syj766/stm32-digital-clock/README.md

# STM32 数字钟（硬件工程）

基于 STM32F103C8T6 核心板的 4 位数码管数字钟。原理图、PCB、DRC、自动布线、铺铜均已完成，并通过嘉立创打样 + BOM 配单下单。

本仓库保存同一原理图的**两版 PCB 设计**：原理图自 V1 起冻结不变，PCB 每版从头重新设计。

> ⚠️ **复刻 / 烧录请用最新 `main` 分支。** 历史版本（含早期 tag）仅供了解演进过程，**不要直接烧录**——引脚分配、蜂鸣器驱动、上电与 RTC 行为都在后续提交中修正过。

> 📌 **最终代码在 [`firmware/最终功能代码/`](firmware/最终功能代码/)**
> 用它覆盖 `firmware/Core/` 中的同名文件即为功能完整的最终工程。
> `firmware/Core/` 保留的是**硬件自检阶段**的旧版本，仅供对照，不要直接烧录。

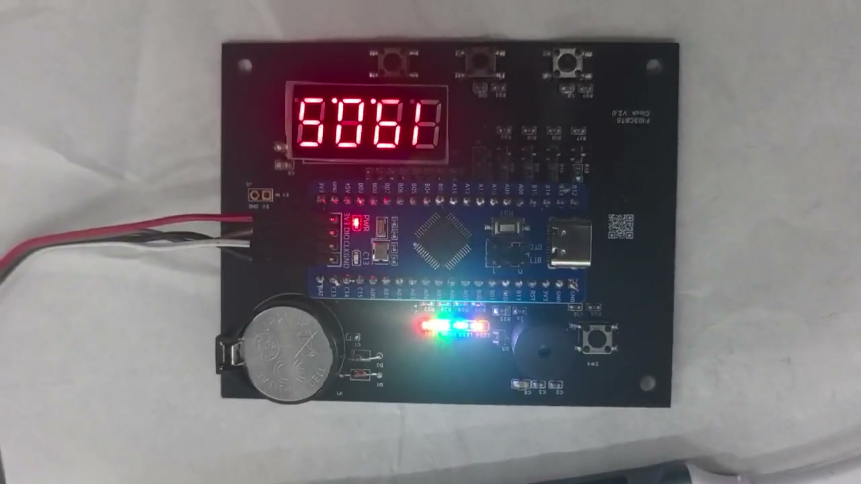
[picture p1: docs/demo/cover.jpg]
数字时钟功能演示（点击封面跳转 B 站播放） (https://www.bilibili.com/video/BV1qnpd61E5a/)


> 📺 **在线观看（B 站）**：[数字时钟功能演示](https://www.bilibili.com/video/BV1qnpd61E5a/)（1 分 50 秒）
>
> 🎬 **仓库内离线版**：[数字时钟功能演示.mp4](docs/demo/数字时钟功能演示.mp4)（720p · 12 MB 压缩版）

| 版本 | tag | 冻结日期 | 说明 |
|---|---|---|---|
| V1 | `v1.0-frozen` | 2026-10-03 | 首版 PCB，产物在仓库根目录 |
| V2 | `v2.0-frozen` | 2026-10-04 | PCB 全面重设计，产物在 `*/v2/` 子目录，详见第十一章 |

- **设计工具**：嘉立创EDA 专业版 V4.1.60

---

## 零、开发总流程（最终版）

> 原则：**IOC 图形化配置 + AI 交叉检查通过后，才开始写代码。**

```text
嘉立创EDA：原理图（引脚分配定稿）→ PCB → ERC / DRC → 打 tag 冻结硬件版本
   ↓
导出四件套放进同一个文件夹：功能需求.md、.epro2、原理图 PDF / 截图（BOM、网表可选）
   ↓
CubeMX：时钟树 + 激活外设 + 处理 Debug/JTAG → 生成 HAL 工程（即“新建空文件夹”）
   ↓
AI 交叉验证：网表 ↔ .ioc ↔ 截图 三方互查，产出 ①比对报告 ②pinmap.h
   ↓
按 .ioc 修正意见重新生成（如需要）→ 定代码框架、写驱动骨架
   ↓
填应用逻辑，上板先跑引脚级自检（按键回显、全段点亮、蜂鸣一声），再上真逻辑
```

**当前进度**：`pinmap.h` 已产出；**焊接后硬件自检程序已完成**（见 [`firmware/`](firmware/README.md)）；⏳ 数字钟功能逻辑待实现。

> **实战：一次 AI 交叉验证如何挖出 .ioc 的 bug（以本工程为例）**
>
> 三方比对时，判断先后从"最省事"到"最实锤"，顺序决定你能否发现隐藏错误：
>
> 1. **先读 `clock.ioc`** → 只知道方向（12 个输出、4 个输入），**看不出谁是谁**；
> 2. **再看原理图截图** `03_5v_input.png` → 拿到"标签 → 引脚"映射，注意 **`SEG_G` 排针 11 脚 = PB3**；
> 3. **解包 `.epro2` 解析 PCB 焊盘网表** → 40 个焊盘逐一实锤，**和截图一致**；
> 4. **拿这份实锤网表回头比对 `.ioc`** → 才发现 **`.ioc` 配了 PA3、漏了 PB3**；
> 5. **把核实结果 + 极性一起写进 `pinmap.h`**。
>
> ```text
> (.ioc: 只有方向) → (截图: 标签→引脚) → (.epro2网表: 40焊盘实锤)
>                                                            ↓
>                           回头比对 .ioc → 抓到 "PA3 重复 + PB3 漏配"
>                                                            ↓
>                                   核实 + 极性 → 写入 pinmap.h
> ```
>
> 结论：**先有鹰眼（截图方向）→ 再用探针（焊盘网表实锤）→ 最后照妖镜（回头比对 .ioc）**，三者缺一不可。

---

## 零·五、STM32 调试口（SWD / JTAG 释放）

> F103 的 **PA13/PA14 是 SWD 调试口**（ST-Link 烧录调试走它），**PA15/PB3/PB4 是 JTAG 脚**，
> 复位后 **5 个全部被调试口占用**。本数字钟拿 **PB3/PA15/PB4 当段选脚**，
> 所以必须在 CubeMX 的 `SYS → Debug` 里释放 JTAG。

**三挡怎么选（结论先行）：开发板一律 `Serial Wire`**

| Debug 挡位 | 释放 JTAG 3 脚 | 保住 SWD(PA13/14) | 适用 |
|---|---|---|---|
| `Serial Wire` | ✅ | ✅ | **开发期唯一正确选项** |
| `Full` | ❌ 全占用 | ❌ | 需 JTAG 时 |
| `No Debug` | ✅ | ❌ 一起禁掉 | 仅量产 / 引脚不够用的极端 |

- **`Serial Wire`**：释放 JTAG 的 PA15/PB3/PB4（拿去当段选），同时保住 SWD（继续可烧录调试）。
- **`No Debug`**：虽然也释放了那 3 个脚，但把 SWD 也一起禁了——**固件一跑调试口就断**，
  下一次烧录热插拔连不上（只能靠拉 NRST 复位下连接，或 BOOT0 救回）。只留给量产且引脚不够的极端情况。
- **烧录发生在固件运行之前**，所以 `No Debug` 不影响**第一次**烧录，**坑的是之后每一次**。

**验收标准**：`hal_msp.c` 里出现 **`__HAL_AFIO_REMAP_SWJ_NOJTAG()`**（即 Serial Wire 已生效，JTAG 释放、SWD 保留）。

---

## 一、架构与集成（定稿）

### 1. 架构

```
        ┌─ main.c（永远只有 5 行，全部落在 USER CODE 段）
        ├────────────────────────┐
        ▼                        ▼
   app.c/.h                 hw_test.c/.h
   应用层：课设逻辑唯一所在    上电自检（唯一允许跨层直推的模块：
        │                    蜂鸣器走 buzzer 驱动、输出走 uart_console）
        │ 装配并调度以下 6 个业务模块
   ┌────┬────┬────┬────┬────┴─┐
seg_display key led buzzer uart_console clock_time
   │    │   │    │      │          │
   └────┴───┴──┬─┴──────┴──────────┘
               ▼
        pinmap.h（引脚+极性唯一事实来源，纯宏无 .c）
               ▼
   CubeMX 生成物（不碰）：main.c 内 MX_GPIO/USART1/TIM3_Init
                        + stm32f1xx_hal_msp.c + Drivers/
   （本工程 CoupleFile=false，无独立 gpio.c/usart.c/tim.c）
```

**三条铁律**：① 引脚宏只从 pinmap.h 取；② 业务模块之间不横向 include，经 app.c 汇聚——**hw_test 是唯一例外**（自检必须跨层直推才能定位故障）；③ main.c 只认识 app.h 与 hw_test.h。

**main.c 的 5 行**（顺序硬约束：`app_init()` 在 `hw_test_run()` 之前，理由见易错点①）。

### 2. 操作清单（已完成 ✓，留档备查重做）

| # | 操作 | 验证 |
|---|---|---|
| ① | 9 个 .h → `Core/Inc`、8 个 .c → `Core/Src`（源：clock_code，**该暂存区已删除**；恢复源=ZCode 工作区备份；**以 Core/ 现行版为准**） | 目录数 12 / 14 |
| ② | 根 CMakeLists.txt `target_sources` 加 8 个 .c | 逐行对上实存文件 |
| ③ | it.c：Includes 加 `clock_time.h` + SysTick 0 段加 `clock_time_isr_1ms();` | grep 两名各 1 次 |
| ④ | main.c 5 行落 USER CODE 段，`app_init` 先行 | 上下文目视 |
| ⑤ | `cmake --preset Debug` + `cmake --build build/Debug` | `Built target clock` |
| ⑥ | 烧录 clock.elf | 上电验收单 |

### 3. 上电验收单

```
LED 流水×2 → 8.8.8.8. 全亮 → 逐位 ×2 → 逐段 → 哔哔哔——哔 → Do Mi So Do↑
→ K1~K4（LED+键号+响）→ 双响 → 00:00 走时（首次上电；有 VBAT 备电则续上次时间）、冒号闪、LED1 心跳、串口每秒报时
```

### 4. 易错点（条条有案底）

1. **初始化顺序**：`app_init()` 必须先行——PWM 只在 `buzzer_init()` 里 `HAL_TIM_PWM_Start`，审查称"buzzer_on 会触发启动"，grep 证伪。
2. **PB0 唯一不能直推引脚**：已归 TIM3（AF），GPIO 写入静默无效，蜂鸣测试走驱动。
3. **修改只落 USER CODE 段**：段外改动被重新生成抹掉。
4. **占空≠GPIO 开关**：无源管 100% 占空 = 直流 = 不响；响 = 50% 方波 @ 谐振 2048Hz。
5. **改主频联动**：`BUZZER_TIMER_CLOCK_HZ` 与时钟树绑定。
6. **JTAG**：保持 Serial Wire；PA13/14 别配 GPIO。
7. **构建**：`--preset Debug`（default hidden）。

---

## 二、板级参数

| 项目 | 参数 |
|---|---|
| 层数 | 2 层（双面） |
| 板材 / 板厚 | FR4 / 1.6 mm |
| 尺寸 | 95 × 75 mm（9.5 × 7.5 cm） |
| 阻焊 / 表面处理 | 绿油 / 无铅 OSP |
| 最小线宽 / 间距 | ≥ 5 mil |
| 过孔 | 0.3 mm 孔 / 0.6 mm 盘（12 / 24 mil） |
| 焊盘距板边 | ≥ 64 mil（1.6 mm） |

## 三、系统框图

模块级拓扑，一眼看清各功能块与主控的挂接关系（矢量源文件：[`docs/system_block_diagram.svg`](docs/system_block_diagram.svg)）。

系统框图

## 四、功能模块

- **显示**：4 位共阳数码管 SR410361N；段选串 100Ω 限流电阻，位选用 S8550 PNP 三极管高边驱动
- **输入**：4 路独立按键（10kΩ 上拉 + 100nF 去抖）
- **提示**：蜂鸣器（S8050 低边驱动）、4 路 LED 指示（灌电流驱动）
- **走时**：RTC + CR2032 备电，采用双二极管「或门」供电切换
- **接口**：USART1 三针排针（PA9 / PA10 / GND）、5V 输入两针排针
- **主控**：立创·地阔星 LCKFB-DKX-STM32F103C8T6 核心板

## 五、BOM

共 **22 行 / 22 种物料 / 59 件**（含地阔星核心板 1 件、1×20P 排母 2 件），立创商城配单 **100% 匹配**。

完整清单见 [`manufacture/clock_BOM.csv`](manufacture/clock_BOM.csv)，每行都带立创 C 编码，可直接导入立创商城 BOM 配单页一键下单。

关键器件：

| 器件 | 型号 | 立创编号 |
|---|---|---|
| 主控核心板 | LCKFB-DKX-STM32F103C8T6 | C22396880 |
| 数码管 | SR410361N（4 位共阳，12 脚） | C132660 |
| 蜂鸣器 | TMB09A05（Φ9 mm，脚距 5.0 mm） | C49246939 |
| 电池座 | KH-CR2032-2-1（插件式） | C5365915 |
| 轻触开关 | K2-1102SP-A4SC-04（6×6×4.3） | C83916 |

## 六、制造与下单记录

| 时间 | 订单号 | 内容 | 金额 |
|---|---|---|---|
| 2026-10-02 23:28 | `clock_PCB1_20261002_232810` | PCB 光板 5 片（双面 / 1.6mm / 绿油 / 无铅 OSP） | ¥0.00（免费打样） |
| 2026-10-03 10:35 | `clock_PCB1_20261003_103524` | PCB 光板 5 片 | ¥30.00（预估） |
| 2026-10-03 | — | 元器件 BOM 一键下单（100% 匹配） | ¥86.96 |

采购方案为「**光板打样 + 立创商城配单 + 手工焊接**」。

## 七、目录结构

```
.
├── README.md
├── .gitignore
├── src/
│   ├── stm32-digital-clock_v1.0.epro2   # V1 源工程（原理图 + PCB + 面板）
│   └── v2/
│       └── stm32-digital-clock_v2.0.epro2   # V2 源工程快照
├── manufacture/
│   ├── clock_Gerber.zip                 # V1 Gerber + 钻孔文件，可直接上传打板
│   ├── clock_BOM.csv                    # 100% 匹配 BOM，可直接导入商城下单
│   └── v2/
│       ├── clock_v2_Gerber.zip          # V2 Gerber（含泪滴）
│       └── clock_BOM.csv                # V2 BOM（与 V1 相同）
├── firmware/                            # 焊接后硬件自检程序（软件，详见 firmware/README.md）
│   ├── README.md
│   ├── clock.ioc                        # CubeMX 配置源头（引脚/时钟/Debug）
│   ├── CMakeLists.txt                   # 构建入口（含 8 个自定义 .c）
│   └── Core/
│       ├── Inc/                         # 9 个自定义头文件
│       └── Src/                         # 8 个自定义 .c + main.c / stm32f1xx_it.c
└── docs/                                # 最终状态截图
    ├── system_block_diagram.svg         # 系统框图（矢量源文件）
    ├── 01_layout.png
    ├── 02_routed.png
    ├── 03_poured_final.png
    ├── v2/                              # V2 PCB 冻结版截图
    │   ├── 00_full_board_all_layers.png
    │   ├── 01_TOP_copper.png
    │   ├── 02_BOTTOM_copper.png
    │   ├── 03_TOP_silkscreen.png
    │   ├── 04_power_rtc_zoom.png
    │   └── 05_mcu_dense_zoom.png
    └── schematic/                       # 原理图分块截图
        ├── 00_schematic_overview.png    # 2 倍高清总览
        ├── 00_contact_sheet.png         # 分块联络表（一览）
        ├── 00_schematic_full.svg        # 矢量源图
        └── 01_usart.png … 07_buzzer_driver.png
```

## 八、复现步骤

1. 用嘉立创EDA 专业版「文件 → 导入工程」打开 `src/stm32-digital-clock_v1.0.epro2`
2. 打开原理图，跑一次 ERC；打开 PCB，跑一次 DRC
3. 确认铺铜已重建（GND 铜皮）
4. 「制造 → 导出 Gerber」+「导出钻孔文件」，或直接用 `manufacture/clock_Gerber.zip` 上传打板
5. 用 `manufacture/clock_BOM.csv` 在立创商城 BOM 配单页下单买料
6. 手工焊接（顺序见下）、上电调试

**焊接顺序**（先贴片后插件、先矮后高）：

0603 阻容 → 0805 阻容 → SOT-23 三极管 → 0805 LED → 贴片轻触开关 → 插件二极管 → 排针 → 排母 → 电池座 → 数码管 → 蜂鸣器 → 最后插核心板（不焊）

> 完整版（逐批位号清单、热板回流实操、锡膏/温度踩坑经验）见 [`docs/焊接工艺.md`](docs/焊接工艺.md)。
> 排母先用核心板插上定位再焊，保证间距；LED / 二极管 / 数码管注意极性。

## 九、注意事项

- `.epro2` / `.zip` / `.png` 都是二进制，Git 无法 diff，**版本追溯依靠 tag**（本版为 `v1.0-frozen`）
- **蜂鸣器**：实物已改焊**无源**电磁管（2048Hz），固件按无源驱动
- 本版按**手工焊接**设计，器件最大为 0603 / 0805 / SOT-23 与插件；后续若加入 QFN / BGA，需转 SMT 一站式
- 打样已完成的板子，任何元件替换**都不能改封装 / 脚距**

## 十、效果图

| 布局完成 | 自动布线完成 | 铺铜完成（最终） |
|---|---|---|
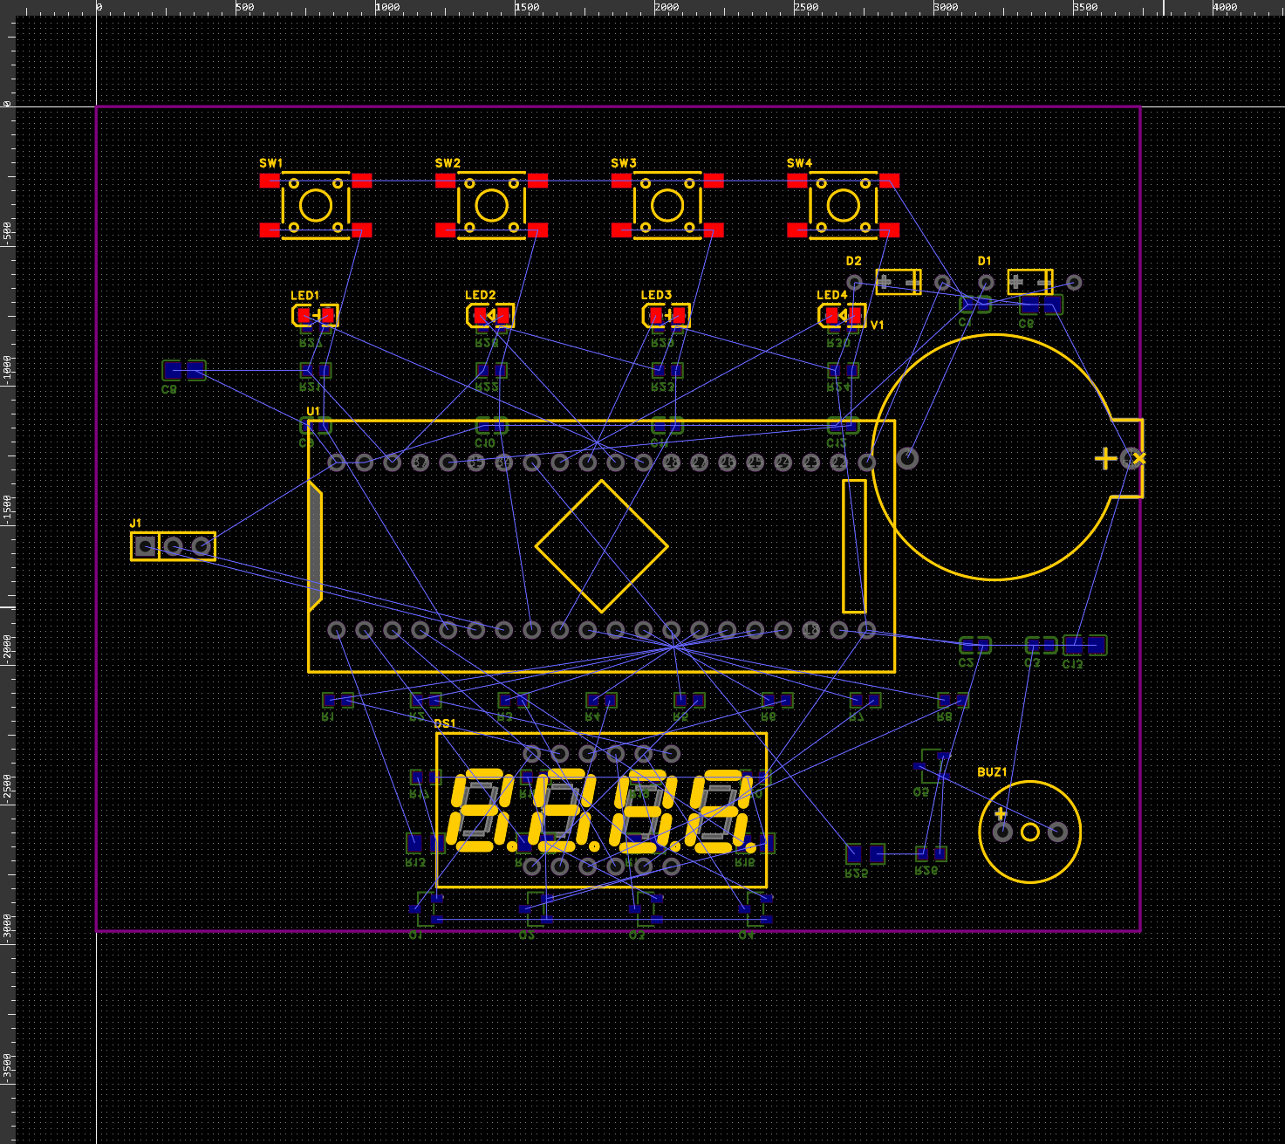
[picture p2: docs/01_layout.png]
布局
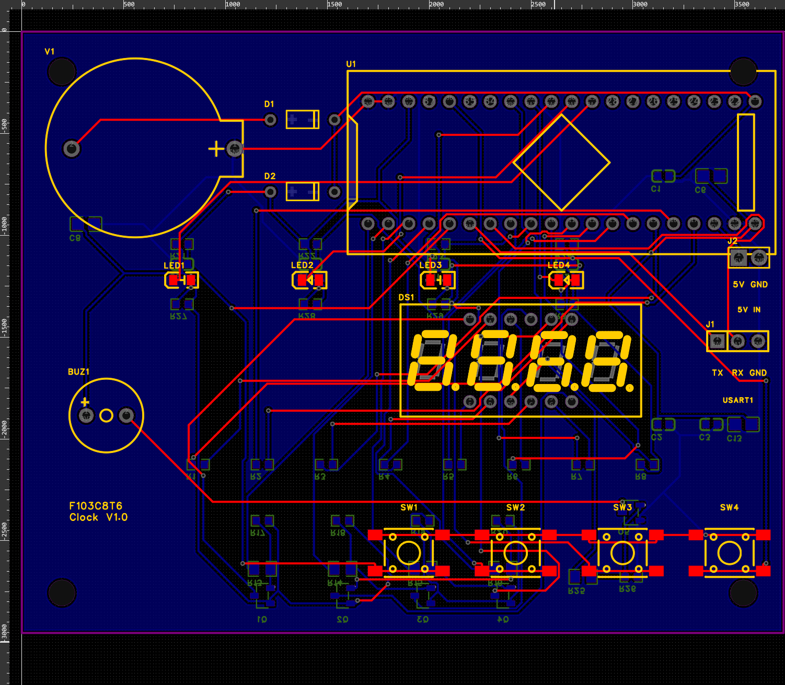
[picture p3: docs/02_routed.png]
布线
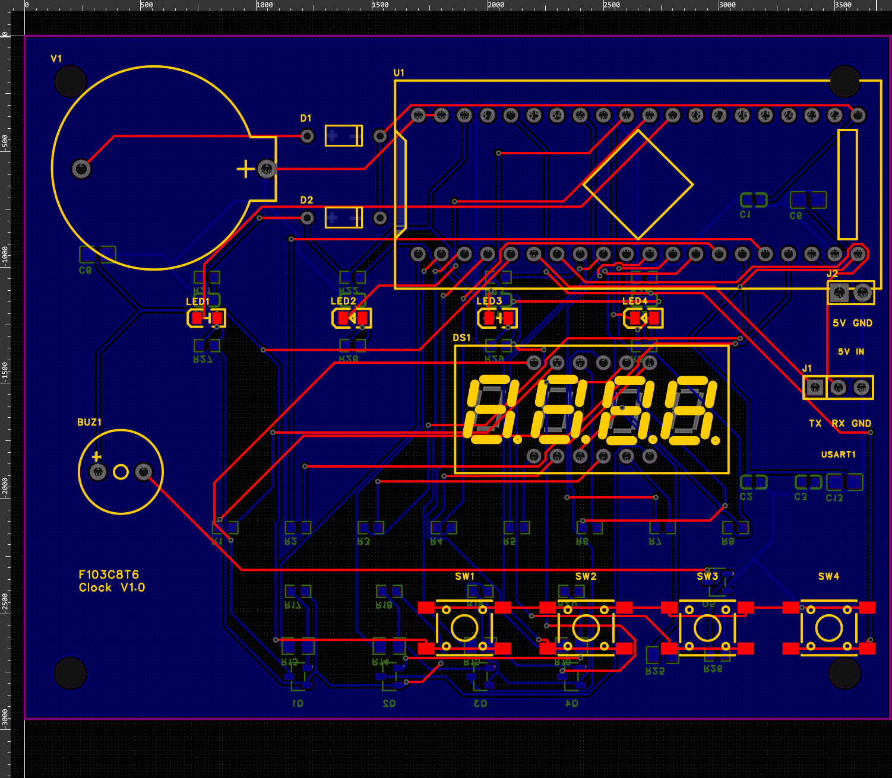
[picture p4: docs/03_poured_final.png]
铺铜
|  |  |  |

## 十一、原理图分块

按功能模块拆分的原理图截图，便于对照 BOM 与 PCB 逐块核对。完整总览见 [`docs/schematic/00_schematic_overview.png`](docs/schematic/00_schematic_overview.png)，分块一览见联络表：

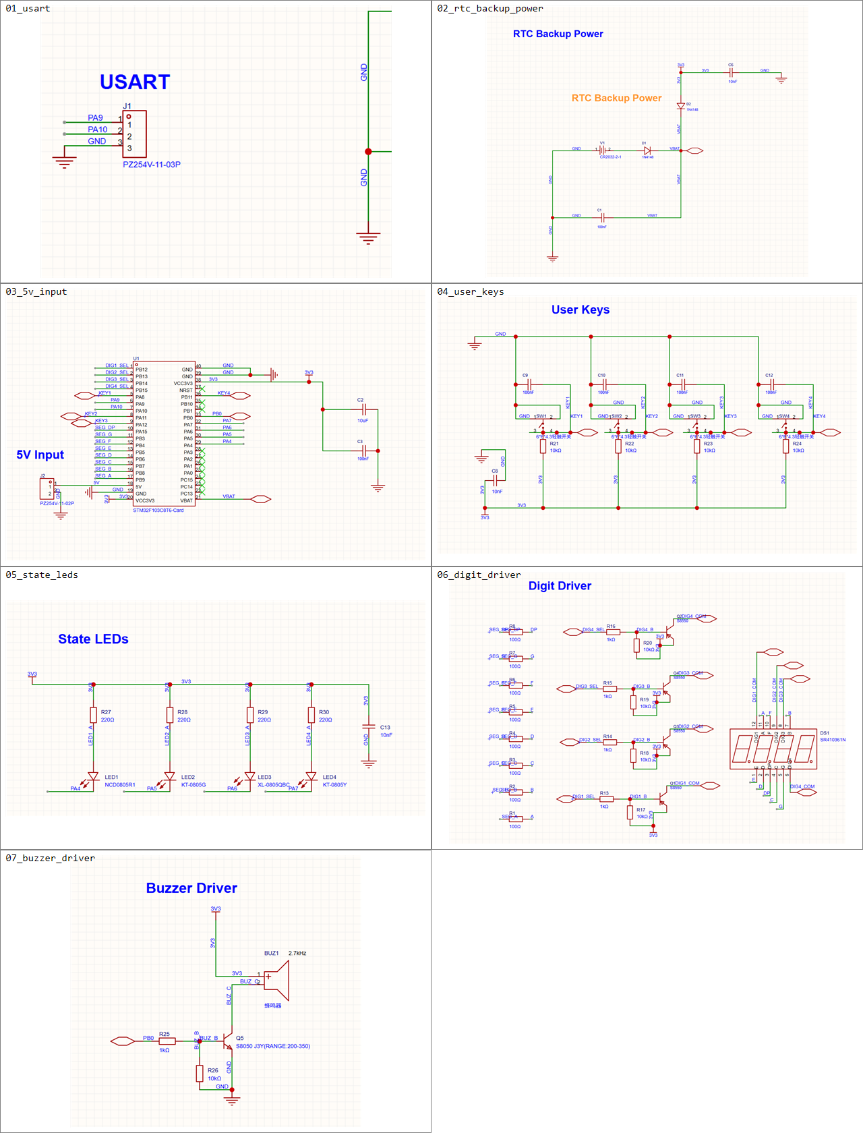
[picture p5: docs/schematic/00_contact_sheet.png]
原理图分块联络表


| # | 模块 | 截图 |
|---|---|---|
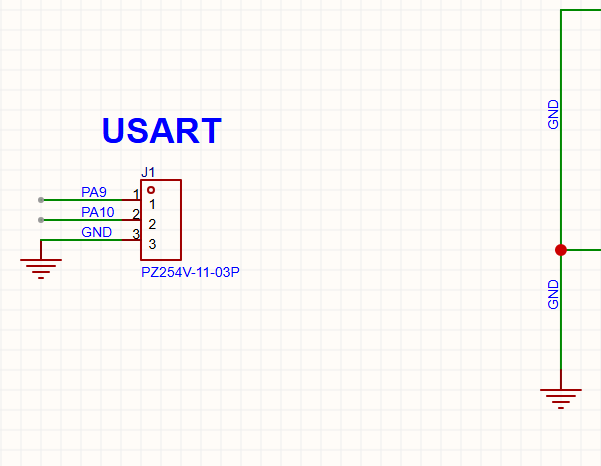
[picture p6: docs/schematic/01_usart.png]
USART
| 01 | USART 接口 |  |
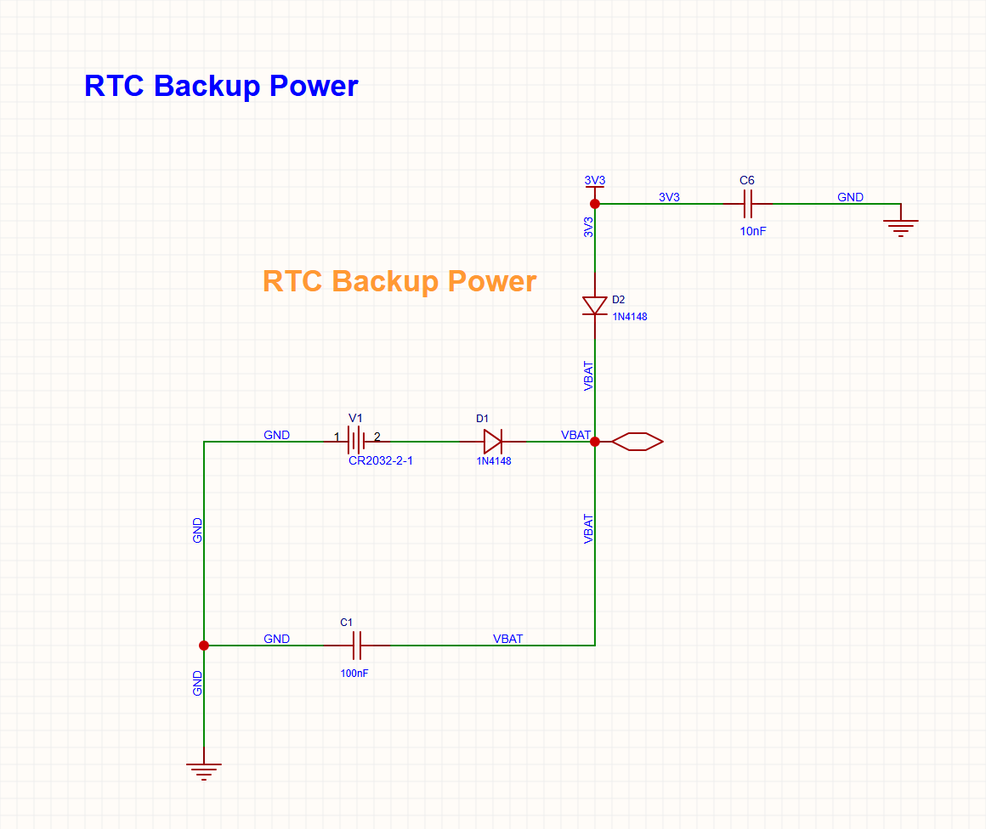
[picture p7: docs/schematic/02_rtc_backup_power.png]
RTC Backup Power
| 02 | RTC 备份供电 |  |
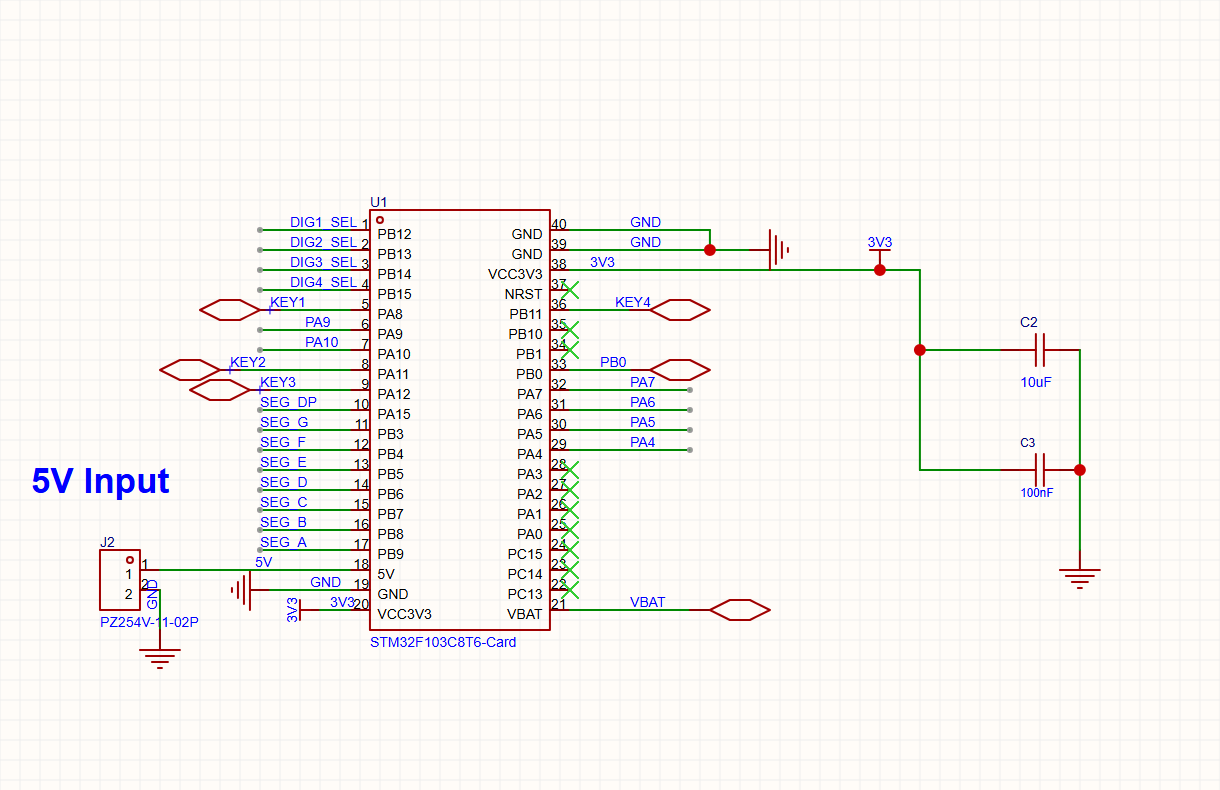
[picture p8: docs/schematic/03_5v_input.png]
5V Input
| 03 | 5V 输入 / 主控核心板 |  |
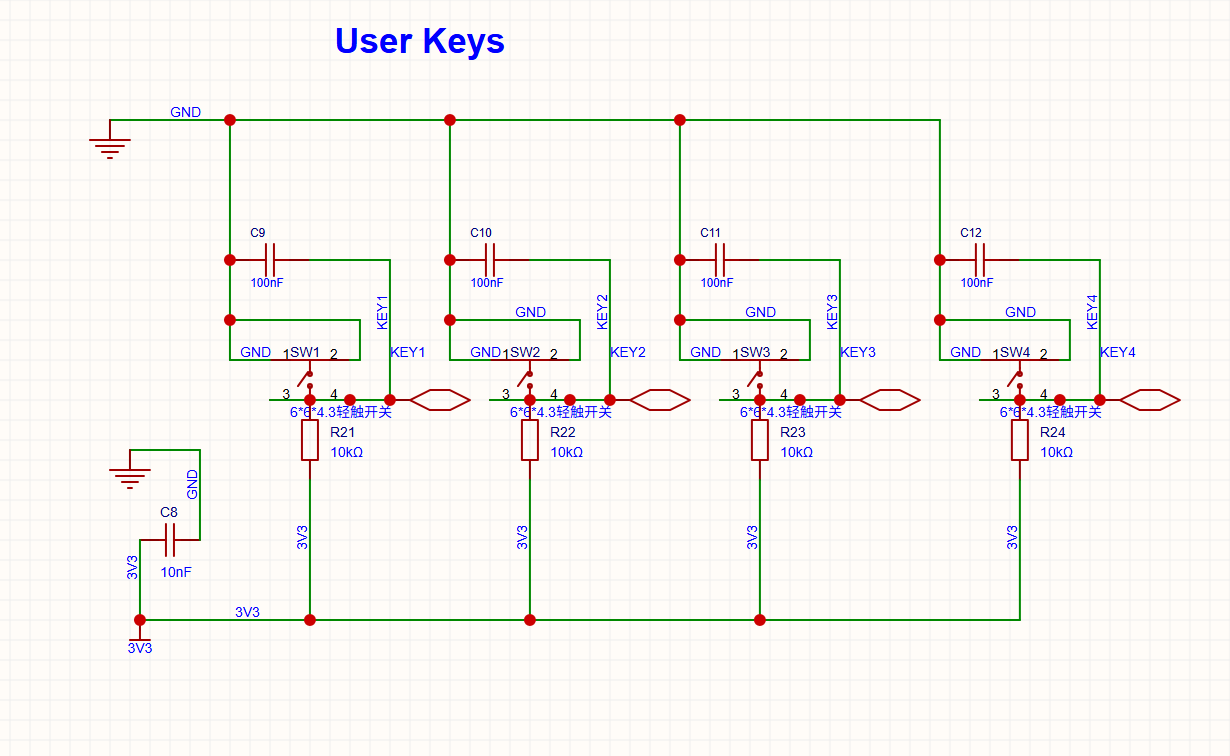
[picture p9: docs/schematic/04_user_keys.png]
User Keys
| 04 | 独立按键 |  |
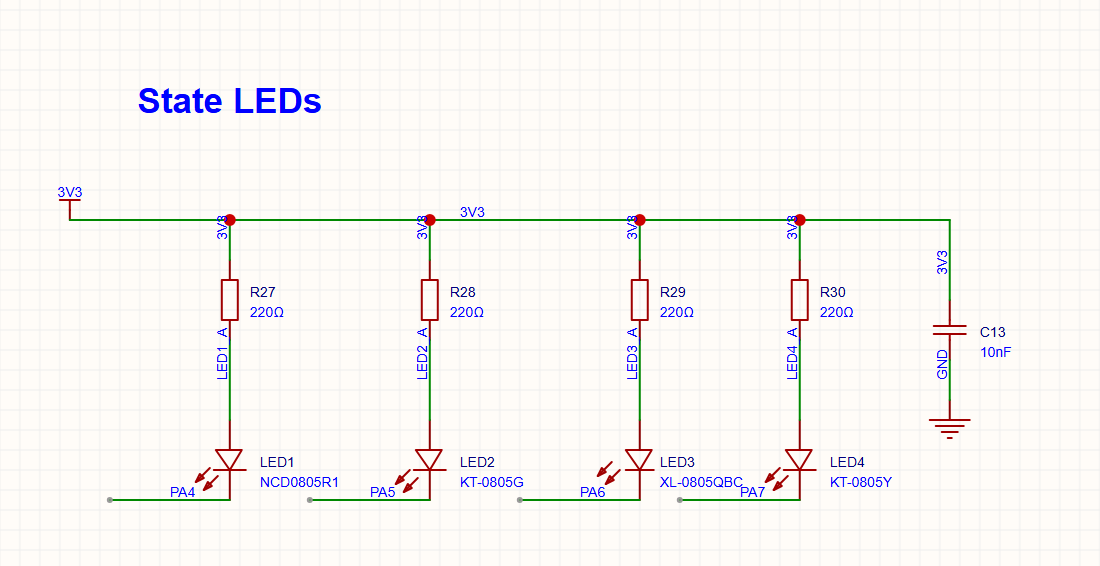
[picture p10: docs/schematic/05_state_leds.png]
State LEDs
| 05 | 状态 LED |  |
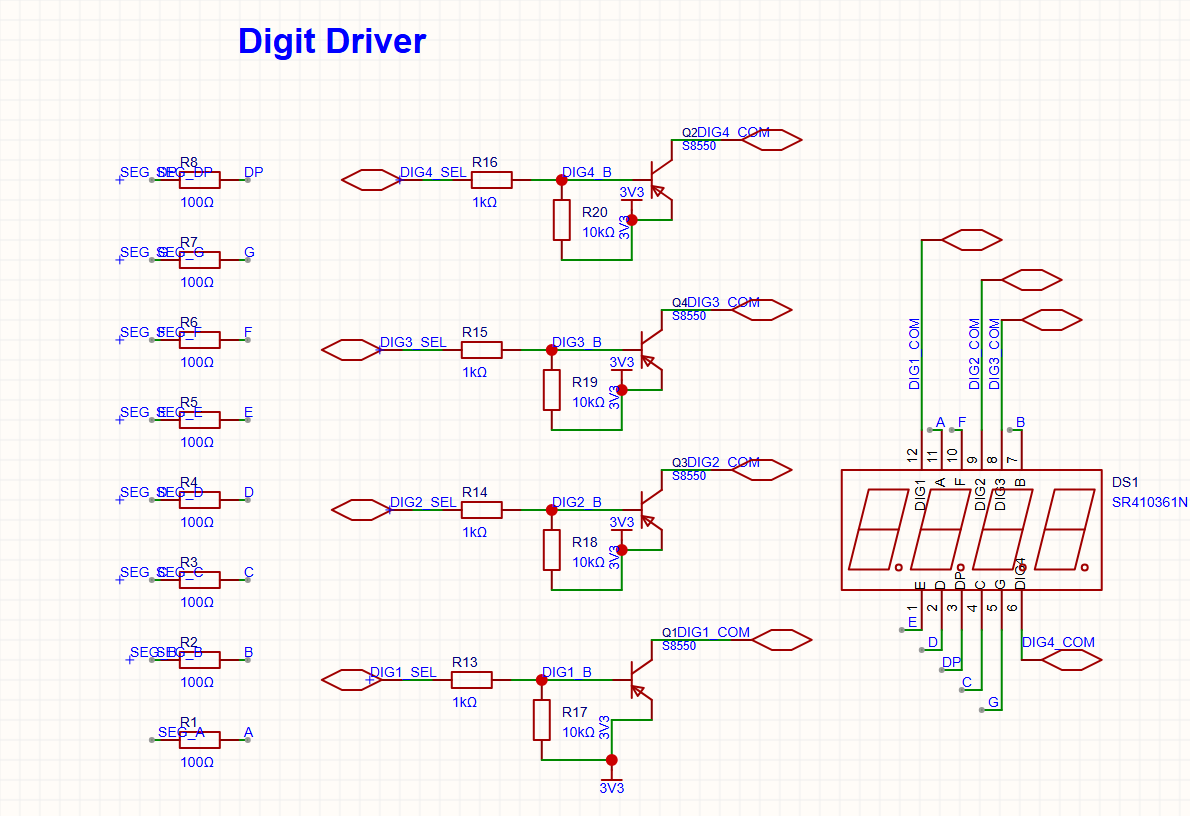
[picture p11: docs/schematic/06_digit_driver.png]
Digit Driver
| 06 | 数码管驱动 |  |
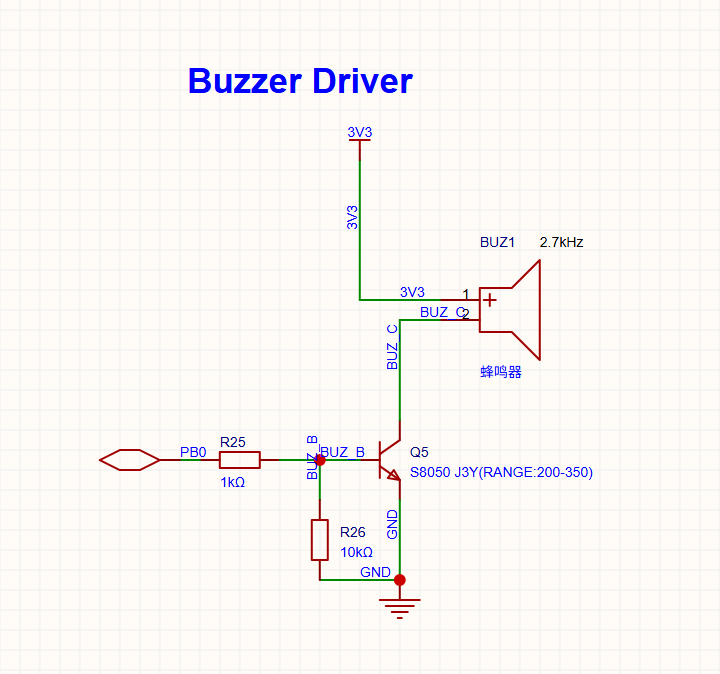
[picture p12: docs/schematic/07_buzzer_driver.png]
Buzzer Driver
| 07 | 蜂鸣器驱动 |  |

## 十二、V2.0 版本（PCB 重设计）

**背景**：原理图自 V1 冻结后未改动，V2 仅对 PCB 从头重新设计，目标是在走线效率、电源完整性与工艺细节上全面超过 V1。BOM 因原理图不变而完全沿用 V1（22 行 / 100% 匹配）。

**V2 产物位置**

| 内容 | 路径 |
|---|---|
| 工程快照 | [`src/v2/stm32-digital-clock_v2.0.epro2`](src/v2/stm32-digital-clock_v2.0.epro2) |
| Gerber（含泪滴） | [`manufacture/v2/clock_v2_Gerber.zip`](manufacture/v2/clock_v2_Gerber.zip) |
| BOM | [`manufacture/v2/clock_BOM.csv`](manufacture/v2/clock_BOM.csv) |
| 核对截图 | [`docs/v2/`](docs/v2/) |

**V1 → V2 指标对比**

| 指标 | V1 | V2 | 说明 |
|---|---|---|---|
| 板框 | 95 × 75 mm | 95 × 75 mm | 不变 |
| 元件布局 | 57 件（TOP 16 / BOTTOM 41） | 57 件（全 TOP） | 改单面布局 |
| 走线段数 | 563 | 453 | −20% |
| 走线总长 | 2715 mm | 1498 mm | −45% |
| 电源线宽 | 单一 10 mil | 10 / 15 / 20 / 25 / 30 mil 五档 | 按网络差异化 |
| 过孔 | 55 | 24 | −56% |
| 铺铜 | 1 区（底层 GND） | 2 区（TOP 3V3 + BOTTOM GND） | 双面整板铺铜 |
| 泪滴 | 0 | 296 | 强化焊盘/走线连接 |
| DRC | 通过 | 0 违规 | — |

**V2 效果图**

| 全层总览 | TOP 铜层 | BOTTOM 铜层 |
|---|---|---|
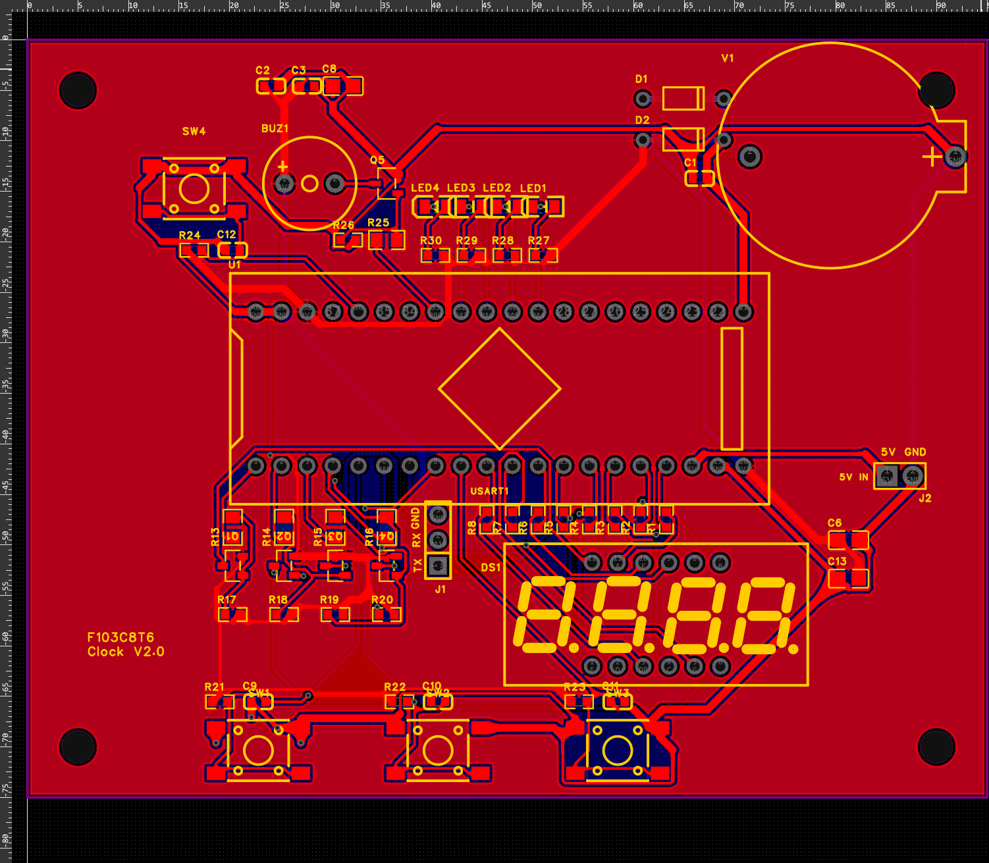
[picture p13: docs/v2/00_full_board_all_layers.png]
全层
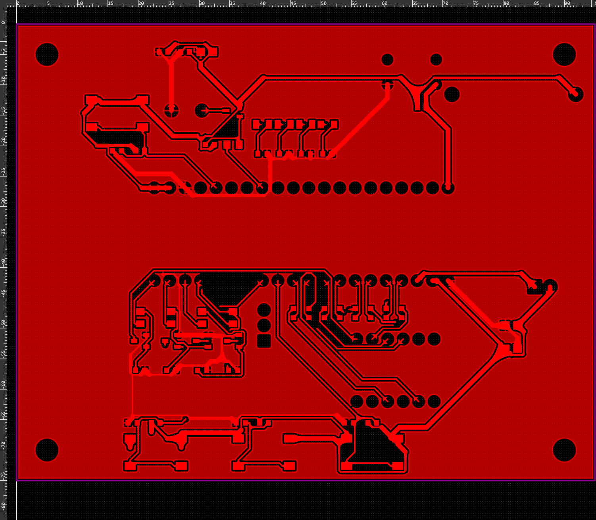
[picture p14: docs/v2/01_TOP_copper.png]
TOP
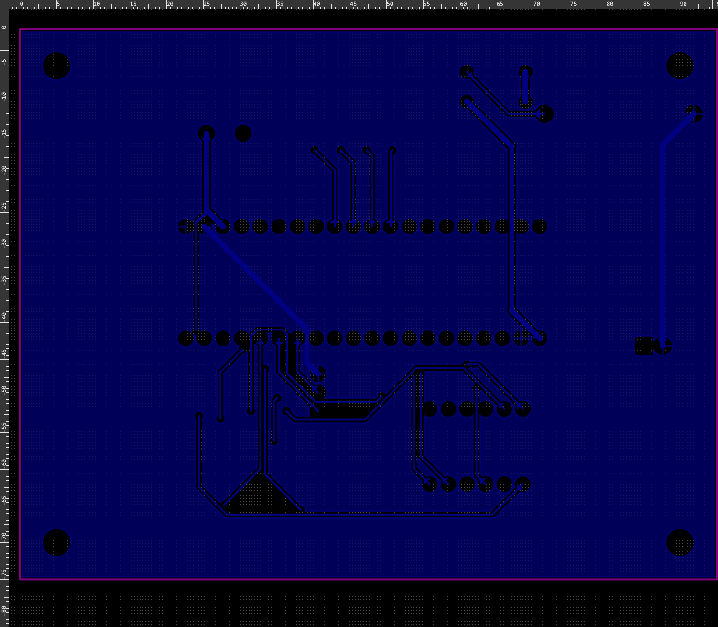
[picture p15: docs/v2/02_BOTTOM_copper.png]
BOTTOM
|  |  |  |

| TOP 丝印 | 电源/RTC 局部 | MCU 密集区 |
|---|---|---|
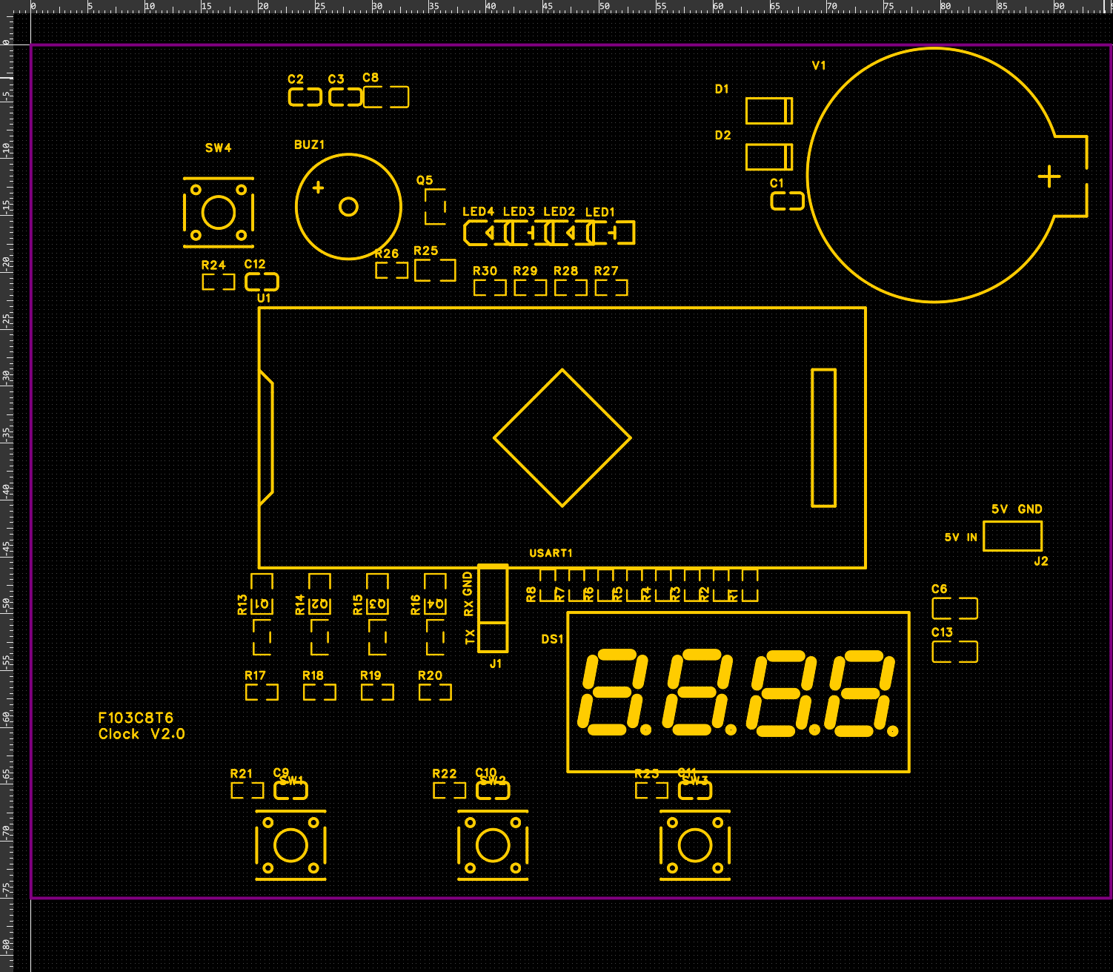
[picture p16: docs/v2/03_TOP_silkscreen.png]
丝印
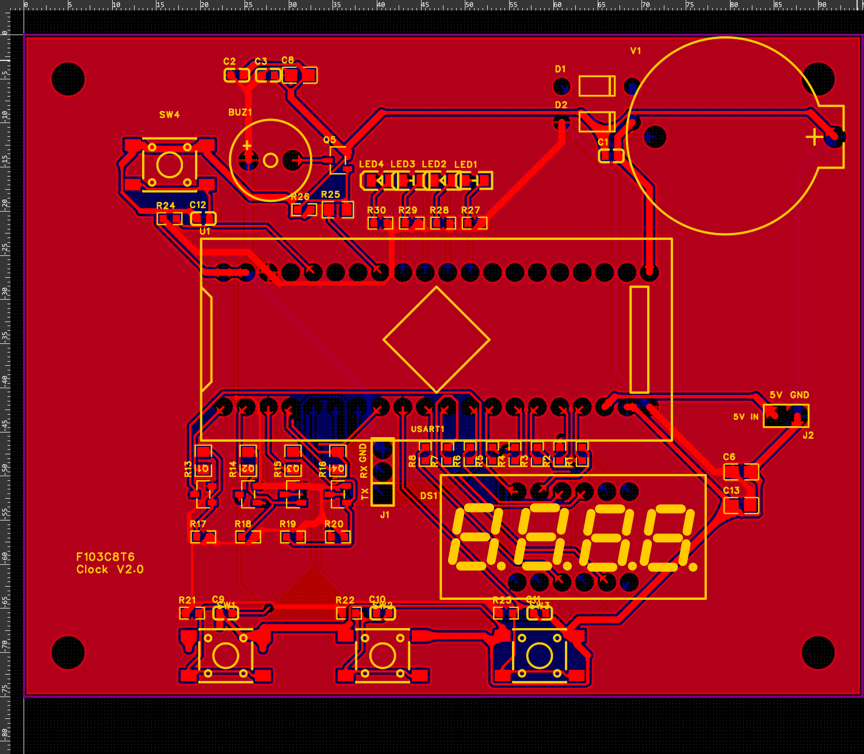
[picture p17: docs/v2/04_power_rtc_zoom.png]
电源
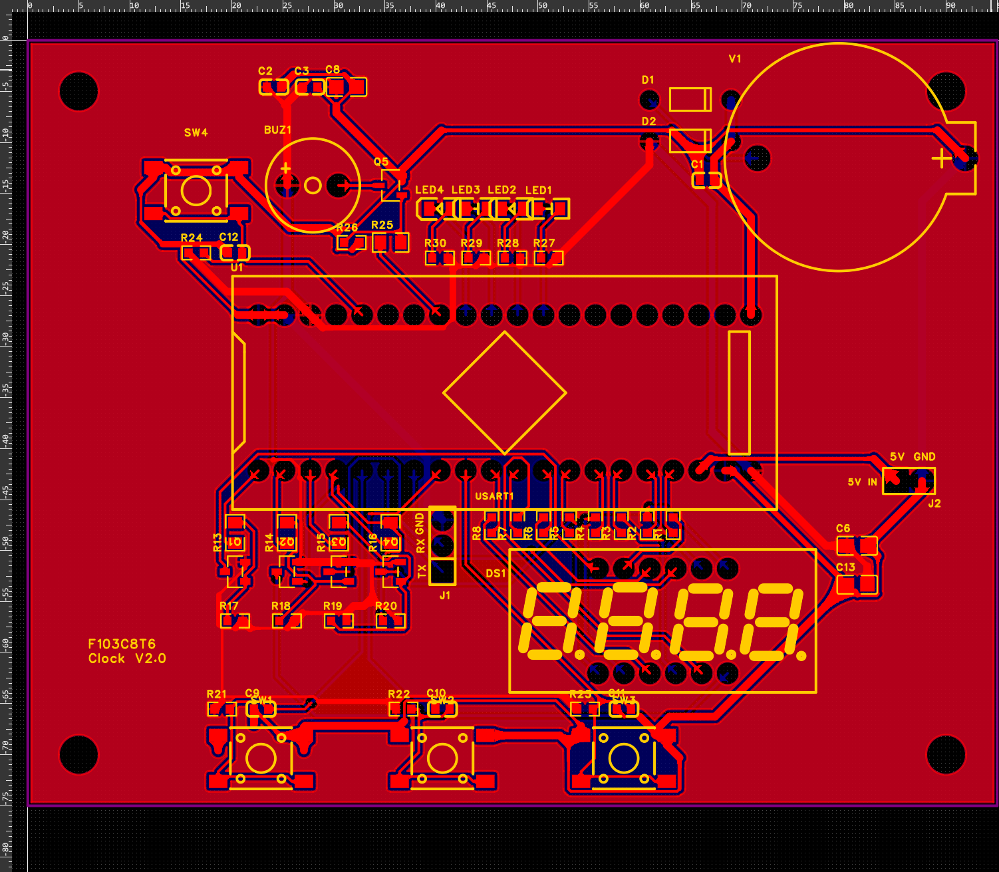
[picture p18: docs/v2/05_mcu_dense_zoom.png]
MCU
|  |  |  |

**复现**：导入 `src/v2/stm32-digital-clock_v2.0.epro2` → 跑 DRC（应为 0）→ 确认 TOP 3V3 / BOTTOM GND 铺铜已重建 → 直接用 `manufacture/v2/clock_v2_Gerber.zip` 上传打板。
