syj766/stm32-digital-clock/docs/schematic/00_schematic_overview.png

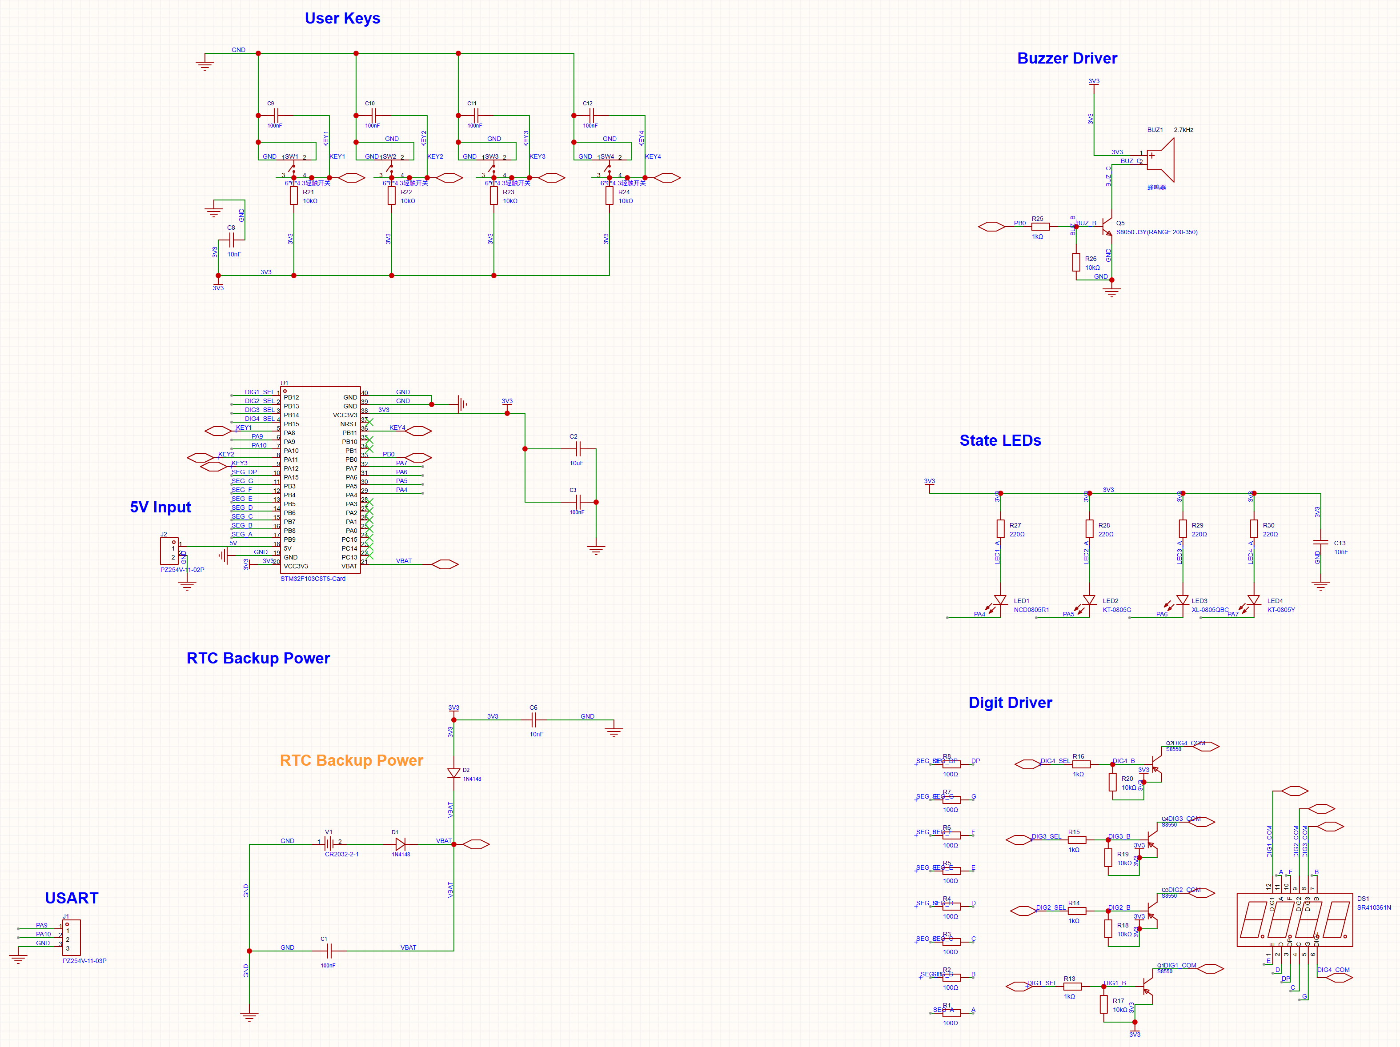
docs/schematic/00_schematic_overview.png
