syj766/stm32-digital-clock/firmware/最终功能代码/main.c

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
/* Includes ------------------------------------------------------------------*/
#include "main.h"

/* USER CODE BEGIN Includes */
#include "app.h"
#include "hw_test.h"
/* USER CODE END Includes */

RTC_HandleTypeDef hrtc;

TIM_HandleTypeDef htim3;

UART_HandleTypeDef huart1;

void SystemClock_Config(void);
static void MX_GPIO_Init(void);
static void MX_USART1_UART_Init(void);
static void MX_TIM3_Init(void);
static void MX_RTC_Init(void);
/**
  * @brief  The application entry point.
  * @retval int
  */
int main(void)
{

  /* MCU Configuration--------------------------------------------------------*/

  /* Reset of all peripherals, Initializes the Flash interface and the Systick. */
  HAL_Init();

  /* Configure the system clock */
  SystemClock_Config();

  /* Initialize all configured peripherals */
  MX_GPIO_Init();
  MX_USART1_UART_Init();
  MX_TIM3_Init();
  MX_RTC_Init();
  /* USER CODE BEGIN 2 */
  app_init();
  /* hw_test_run();  -- 硬件自检已通过，跳过以直接播放旋律 */
  /* USER CODE END 2 */

  /* Infinite loop */
  /* USER CODE BEGIN WHILE */
  while (1)
  {
    /* USER CODE END WHILE */

    /* USER CODE BEGIN 3 */
    app_task();
  /* USER CODE END 3 */
  }
}

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
