syj766/stm32-digital-clock/(commit log)

2026-10-03 chore(release): 冻结 STM32 数字钟 v1.0 硬件版本
    首次冻结：源工程 epro2 + Gerber + 100% 匹配 BOM + 关键状态截图。对应已完成的打样参数与元器件下单参数（PCB 5 片 1.6mm 绿油 OSP，BOM 22 行 21 物料）。
    [clock_BOM.csv]
2026-10-03 docs(schematic): 新增原理图分块截图与总览图
    按功能模块拆分为 7 张分块图（USART / RTC 备份供电 / 5V 输入 / 独立按键 / 状态 LED / 数码管驱动 / 蜂鸣器驱动），并附 2 倍高清总览图与分块联络表，便于队友在 Git 仓库中快速查看原理图。
2026-10-03 docs(readme): 补充原理图分块章节与目录结构
    在 README 中嵌入分块联络表与 7 张模块截图，并把 docs/schematic 纳入目录树，方便队友直接浏览。
2026-10-03 docs: 新增系统框图（SVG）并嵌入 README
2026-10-03 fix(bom): 补充排母行并合并重复料行，同步修正 README 统计
    [clock_BOM.csv]
2026-10-03 docs(readme): 补充焊接顺序
2026-10-04 chore(release): 冻结 STM32 数字钟 v2.0 硬件版本（PCB 重设计）
    [clock_BOM.csv]
2026-10-06 README: 在顶部新增开发总流程(最终版)章节
2026-10-06 README: 开发总流程补 AI 交叉验证实战(挖出 .ioc 漏配 PB3)
2026-10-06 README: 新增 STM32 调试口 SWD/JTAG 释放章节
2026-10-06 README: 作为第一节新增架构与集成定稿笔记, 后续章节顺延
2026-10-06 Revert "README: 作为第一节新增架构与集成定稿笔记, 后续章节顺延"
    This reverts commit c29c3ba8f2e6eb850113aa7b62e9b0d7b0da04ef.
2026-10-06 README: 第一节替换为架构与集成定稿笔记 v2
2026-10-06 README: 记录蜂鸣器有源/无源实物偏差(BOM配单有源, 实物改焊无源)以消除文档矛盾
2026-10-06 README: 蜂鸣器有源/无源提示精简为注意事项一句
2026-10-06 README: 蜂鸣器有源/无源提示措辞改顺
2026-10-06 README: 蜂鸣器注意事项删后半警示段, 只留实物事实
2026-10-09 feat: 新增 firmware/ 焊接后硬件自检程序（clock.ioc + CMakeLists + Core 源码 + 说明）
2026-10-11 fix(firmware): pinmap.h 用本地定稿覆盖（SEG_G=PB3 已修正 / 蜂鸣器无源 PWM）
2026-10-11 fix(firmware): clock_time.c 用本地定稿覆盖（ISR 注释更新）
2026-10-11 docs(firmware): README 用本地定稿覆盖，保留自检定位说明 + 延伸阅读
2026-10-11 docs(firmware): 新增 PWM 初始化顺序笔记
2026-10-11 docs(firmware): 延伸阅读补充《从零搭建 HAL 工程》流程链接
2026-10-11 docs(firmware): 恢复 README 并补充《从零搭建 HAL 工程》流程链接
2026-10-11 docs: 新增《焊接工艺》——57 颗元件焊接顺序、热板回流实操与虚焊复盘
2026-10-11 docs(readme): 焊接顺序处补充《焊接工艺》链接
2026-10-12 fix(firmware): main.c 增加 RTC 掉电续走（抢救/回写 + BKP 标记）
2026-10-12 feat(firmware): clock_time 上电读 RTC 续表、set 同步写回 RTC
2026-10-12 docs(firmware): 新增《RTC 掉电续走》设计说明与注意事项
2026-10-12 docs(firmware): 上电时间口径改为 00:00:00(RTC) 并补《RTC 掉电续走》链接
2026-10-12 docs(readme): 顶部提示「复刻/烧录请用最新 main」；上电验收单口径 12:00 -> 00:00
2026-10-12 docs(firmware): 新增「最终功能代码/」16... 五功能最终版 9 .c + 9 .h 存档
    - 内容：app/buzzer/clock_time/hw_test/key/led/main/seg_display/uart_console
    对应 9 个同名 .h（含 pinmap.h）
    - 最终功能：走时 / 秒表 / 倒计时 / 闹钟 / 时间调整 五模式
    + 超级马里奥启动旋律 + 模式 LED 指示
    - 原 firmware/Core/Inc 与 firmware/Core/Src 保持不动（硬件自检阶段代码）
    - 统一 LF 换行，便于与 Core/ 版本逐行对照
2026-10-12 docs: 标注「最终功能代码/」为最终版
    - 根 README 顶部新增导流提示：最终代码在该目录，覆盖 Core/ 同名文件即为最终工程
    - 新增 firmware/最终功能代码/README.md：用法、与 Core/ 的差异、模式 LED 指示、框架文件补齐说明
2026-10-12 docs(readme): 导流提示与上方警示块之间补空行，避免 Markdown 把两个引用块合并成一段
2026-10-12 docs(demo): 新增功能演示视频（ffmpeg 压缩 33.2MB -> 12.2MB，720p/1分50秒）+ 根 README 加演示链接
2026-10-12 docs(demo): 新增 B 站演示视频封面并改为点封面跳转，仓库内保留离线压缩版
