syj766/stm32-digital-clock/(notices)

Notices in the files:
firmware/最终功能代码/main.c:
Copyright (c) 2026 STMicroelectronics.
All rights reserved.
This software is licensed under terms that can be found in the LICENSE file
